V-Vekaria/LightGuide-Edge/deliverables/VekariyaVishnuB00969091_Slides.pptx

LightGuide Edge

A camera-free device that tells a photographer how to fix their lighting — in 21 microseconds, on a microcontroller.

Vishnu Vekariya · B00969091 · COM683 Edge and Embedded Intelligence · CW2

Notes: Open with the problem in one sentence, not an agenda. 12 minutes, 15 slides.

## Slide 2

The problem

Small-studio and freelance photographers have no feedback loop on lighting setup

- Lighting is set by eye, then re-set by eye at every session. Nothing records what "correct" was.
- Getting it wrong costs a reshoot: wasted travel, wasted studio hire, wasted energy — SDG 12, responsible consumption.
- The people worst affected are freelancers and small businesses without an assistant or a light meter — SDG 8, decent work and productive employment.
- Existing aids are cameras or phone apps: they need a lens pointed at the subject, which is a privacy problem in client work.

The opportunity for innovation

A sub-£30 device that senses geometry and light directly, judges the setup against a saved reference, and guides the operator back — with no camera, no cloud and no personal data.

£30

0

5

bill of materials

images captured

setup faults detected

Cost and privacy are the two barriers this removes.

Notes: Say the phrase 'opportunity for innovation' out loud — the top band language is explicit. Ground SDG 12 in reshoots, SDG 8 in freelancers without an assistant.

## Slide 3

The solution, and why machine learning earns its place

Sense → classify → guide, as a closed loop on the device

1 Sense

Ultrasonic range and an LDR, sampled at 8 Hz. The LDR is read inside the ultrasonic ping gaps so the two channels never contend.

2 Classify

A window of 10 samples becomes 8 features, classified on-device into one of five setup states.

3 Guide

OLED text, an LED and a buzzer whose pitch encodes direction and rate encodes urgency.

Why not a pair of thresholds?

Because the two channels are physically coupled. Illuminance falls with the square of distance, so moving the stand changes the light reading even when the lamp has not been touched. A fixed light threshold therefore fires on a distance error, and a fixed distance threshold misses a lighting one. The classifier learns the joint region instead — and the ablation on slide 12 measures exactly what that coupling is worth: 0.41 and 0.46 macro-F1 for each channel alone, 0.87 together.

Placed at the edge, deliberately

Inference is 21 µs against a 125 ms sensing period, so the loop is bound by physics, not compute. Nothing leaves the device — the privacy argument and the latency argument point the same way here (Buyya and Srirama, 2019; Situnayake and Plunkett, 2022).

Notes: The inverse-square coupling is the intellectual core of the project. If you only get one idea across, make it this one.

## Slide 4

Ethical, technical and social context

What the design chooses not to do is as important as what it does

Ethical — privacy by construction

No camera, no microphone, no images, no personal data. The device cannot identify a person because it never senses one: it measures distance to a surface and light falling on a cell. Privacy is a property of the sensor choice, not of a policy.

Technical — the constraint is RAM

46.7 KB of 256 KB static RAM and 12.3% of flash. On microcontrollers the binding limit is memory, not arithmetic (Warden and Situnayake, 2019), which is why an 8-feature tree beats a neural network here.

Social — who it is for

Aimed at freelancers and small studios, the users least able to absorb a reshoot. A sub-£30 device with no subscription and no account is accessible in a way a metered app is not.

Notes: Trim this slide first if running over time.

## Slide 5

Data collection methodology

1,832 labelled samples · 45 runs · 3 sessions · 5 classes · 0 dropouts, 0 NaNs

- Five classes: optimal, too_close, too_far, underlit, overlit. Each defined relative to a saved reference setup, not to an absolute distance — so a reference saved next week still works.
- Three sessions on different days, with the rig re-referenced each time. Session 3 is held out entirely and never seen during training.
- 8 Hz sampling: fast enough to catch the operator settling, slow enough that the ultrasonic ping and the LDR settling do not contend.
- The staged label is written by the host at the moment of the trial, so ground truth is recorded, not reconstructed from memory afterwards.

Why session-split, not random

At 8 Hz consecutive samples are near-duplicates. A random split puts near-identical windows on both sides and reports a score that measures memorisation. Splitting by session — and grouping cross-validation by run — makes the test set answer the question that matters: does this work on a day it has not seen?

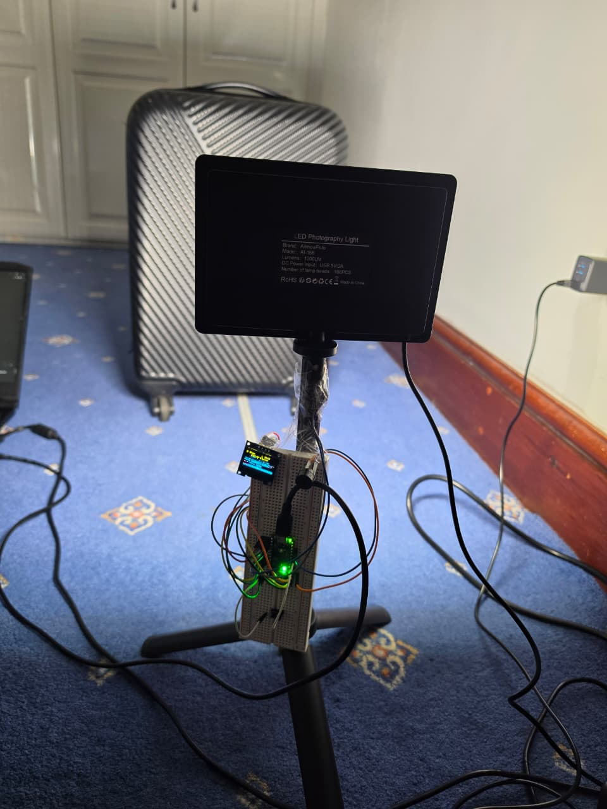
[picture p2: figure]

The rig as used for collection: lamp and sensor board on one stand.

Notes: The session-split argument is the highest-value point on the 15% data row. Say it explicitly.

## Slide 6

Data quality controls

Calibration against an independent reference, then filtering, gating and audit

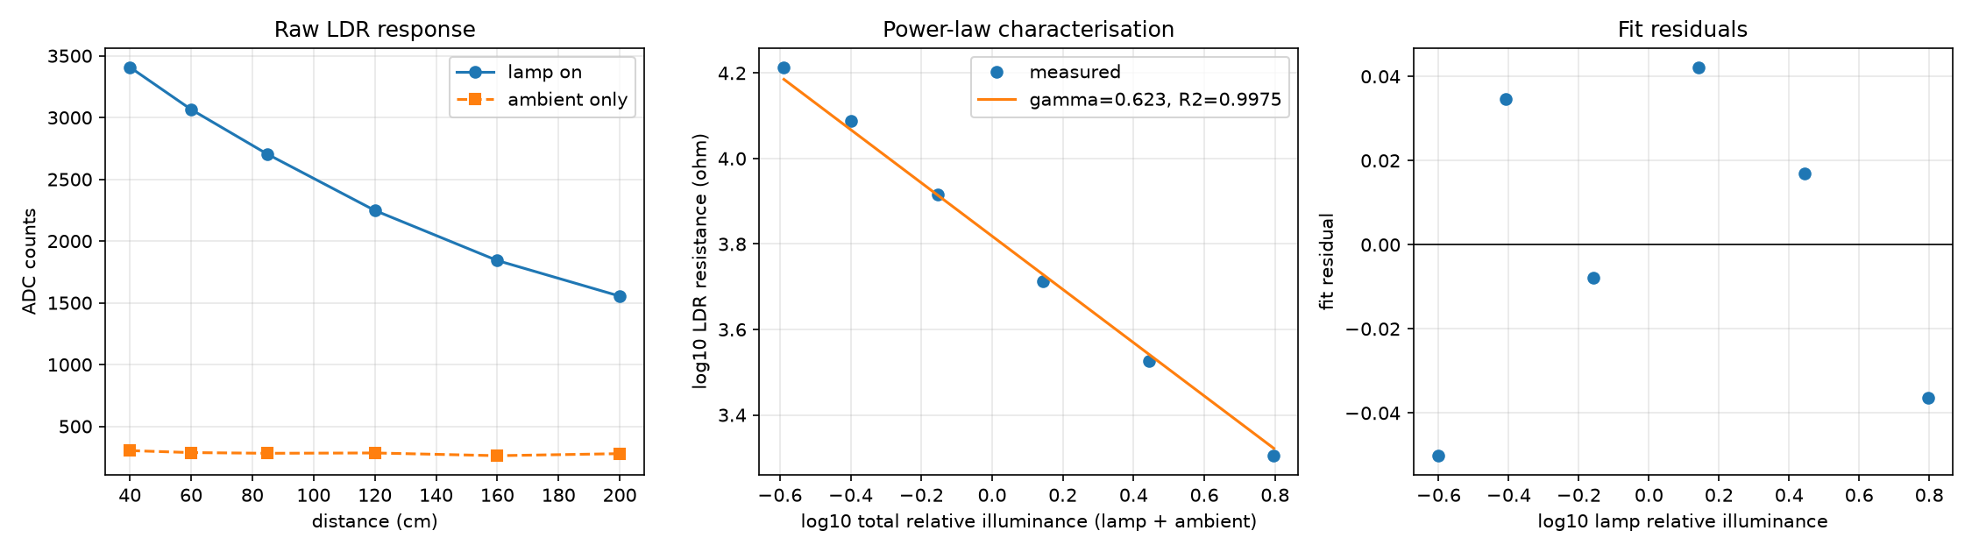
[picture p3: figure]

Six-point sweep, 40–200 cm, lamp output held fixed; distance is the reference instrument via the inverse-square law.

Ambient is fitted, not assumed

A lamp-off reading at every distance gives the room's own contribution, subtracted in the resistance domain — counts are non-linear in illuminance, so subtracting counts would subtract the wrong quantity.

0.623

0.9975

0.9913

7.2 mm

A measurement, not a convenience

One point at 200 cm read 134 mm long while every other read 1–22 mm short. The beam cone is 527 mm wide there against a 200 mm target, so the echo came off the wall behind. It is auto-flagged and excluded, and the report shows it rather than hiding it.

LDR γ (CdS band 0.5–0.9)

R² of the power-law fit

APDS9960 cross-check r

ultrasonic RMSE ≤160 cm

Notes: If asked why no lux meter: absolute lux is not needed because every class is relative to a saved reference. What is needed is the response curve, and distance gives that for free.

## Slide 7

Preprocessing and features

Two channels, ten samples, eight numbers

Windowing

10 samples at 8 Hz = 1.25 s, 50% overlap (stride 5). Long enough to average out a bad echo, short enough that the operator is not left waiting.

Deviations, not absolutes

Both channels are stored as a difference from the saved reference: d_dist_mm and d_ldr. The model learns how far off the rig is, not where it happens to be standing.

Eight features

mean, std, min, max — for each of the two channels. Chosen to be computable in a single pass on-device with no buffering beyond the window itself.

Leakage avoided at every step

The scaler is fitted on training data only and frozen before it ever touches the test session. Cross-validation is grouped by run, so no two windows from the same run can land on opposite sides of a fold.

Readings the model was never trained on are refused

A failed echo was dropped from the dataset rather than interpolated, so the firmware also refuses to push one into the classifier. The device shows the channel as unread instead of inventing a value — the training and deployment paths make the same choice.

Notes: The frozen-scaler and grouped-CV points are what separates a 2:1 from a 1st on the ML row. State both.

## Slide 8

Four modelling approaches, and why each

Nothing was tuned to flatter one side

M0 Classical baselines

Decision tree, k-NN, logistic regression, random forest. A tree is interpretable and its split thresholds can be checked against the physical tolerances — when they agree, that is independent evidence the dataset is sane.

M1 MLP (32-16)

The obvious neural baseline on the same 8 features. Tests whether a learned non-linear boundary beats an axis-aligned one on this problem.

M2 Autoencoder novelty gate

Trained on optimal windows only. High reconstruction error means "this is not a setup I recognise", so the device can say UNKNOWN SETUP rather than confidently pick a wrong class.

M3 Sequence model / Edge Impulse

Same windows, same splits — but 20 raw timestep values instead of 8 summary statistics, trained as an INT8 TFLM network in Edge Impulse.

Notes: M2 is the closest thing here to a novelty claim — but its recall is 0.169, so present it as a partial result, not a success.

## Slide 9

Validation and deployment

Grouped 5-fold CV, a held-out session, and a footprint measured rather than estimated

- 5-fold cross-validation grouped by run; 195 training windows, 104 held-out test windows from session 3.
- Five seeds per model — the reported spread is real variance, not a single lucky run.
- Deployed model is the decision tree, exported to model.h as plain C: no library dependency, no tensor arena, no quantisation error.
- Footprint read from the compiler, not estimated — regenerate with tools/record_footprint.py.

The INT8 network exists — and was not deployed

CW1 promised an INT8 TensorFlow Lite Micro model. It was built in Edge Impulse on identical windows (195 train / 104 test on both sides) and measured. The tree beat it by 20 percentage points, so the tree shipped. Choosing not to deploy is a result, not an omission.

120,896 B

46,696 B

20.8 µs

Public project

studio.edgeimpulse.com/public/1082649/live — Vish_Vekzz / LightGuide-Edge, open without a login.

flash — 12.3% of 983,040

static RAM — 17.8% of 256 KB

mean inference, p95 21.0

Notes: Have the EI page open in a tab in case they want to see it during Q&A.

## Slide 10

Results — offline

Held-out session 3, never seen in training

model | CV macro-F1 | test macro-F1
M0a Decision Tree | 0.882 ± 0.237 | 0.868
M0d Random Forest | 0.896 ± 0.207 | 0.868
M1 MLP (32-16) | 0.858 ± 0.138 | 0.860
M0c Logistic Regression | 0.849 ± 0.148 | 0.786
M0b k-NN (k=5) | 0.784 ± 0.161 | 0.800
Majority baseline | — | 0.067

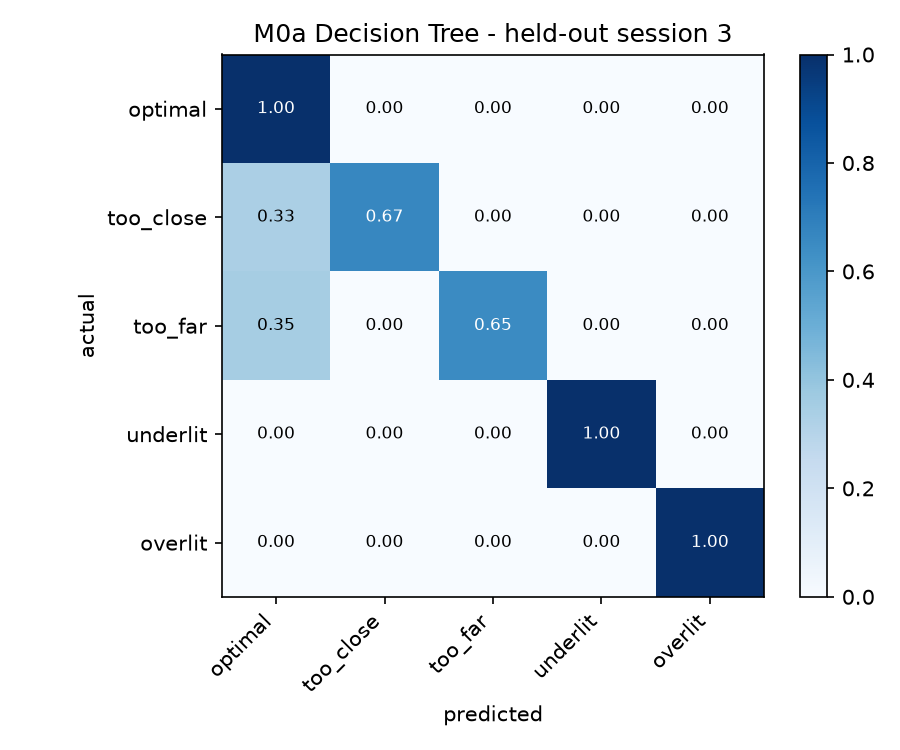
[picture p4: figure]

Every error is a distance class absorbed into optimal: too_close recall 0.67, too_far 0.65, both channels' lighting classes 1.00.

The generalisation gap is the point

CV 0.882 against held-out 0.868 — a gap of +0.014. Session-wise splitting exists to expose exactly this number; a random split would have hidden it and reported something flattering and false.

Notes: Optimal has precision 0.60 with recall 1.00 — it over-predicts. That is the near-boundary region, and it sets up slide 11.

## Slide 11

Results — online, on the device, in the room

40 staged runs · 1,648 classified samples · 0 dropouts

1.000

20.8 µs

8.09 Hz

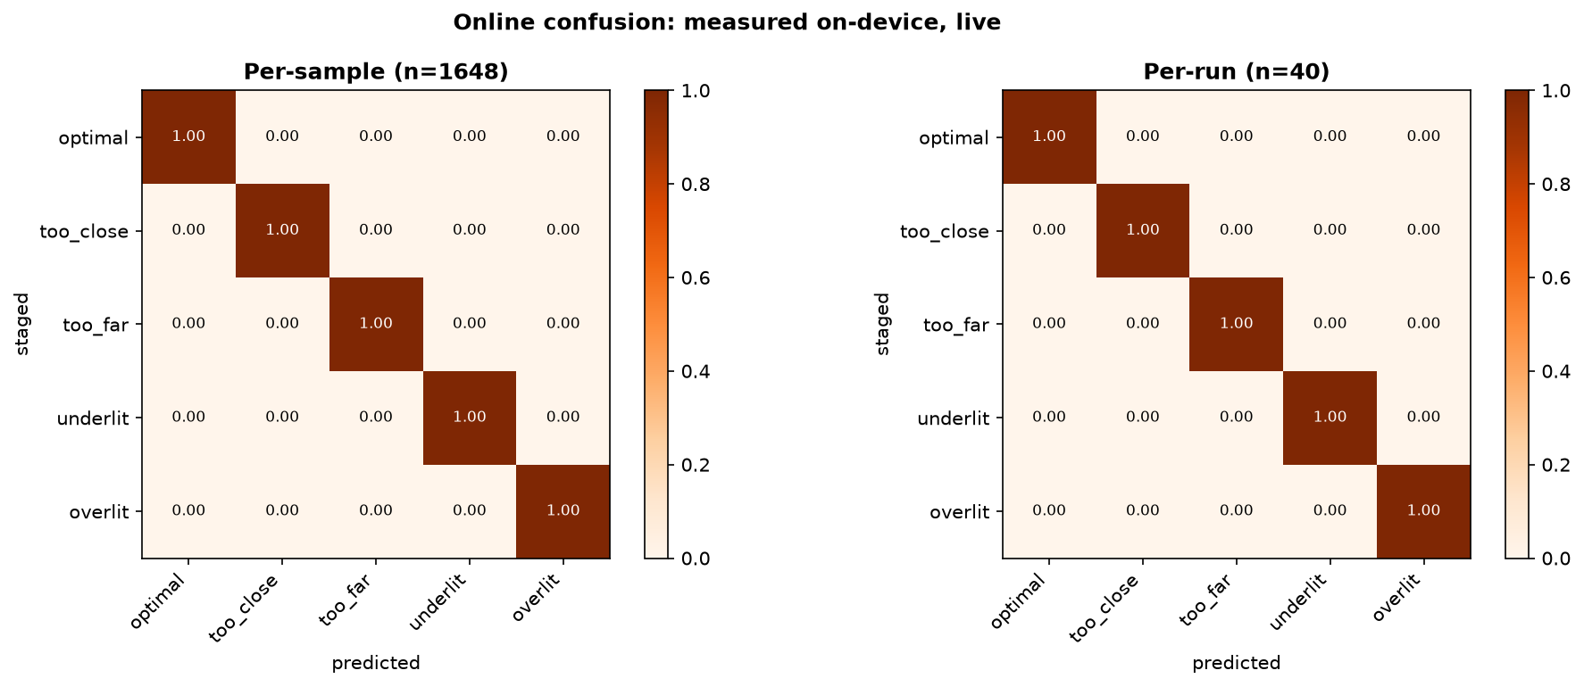
[picture p5: figure]

What it does establish: the deployed model reproduces its intended behaviour on every prototypical staging, with ground truth recorded at the trial.

per-run macro-F1

mean inference

sustained sample rate

Why 1.000 is NOT better than the offline 0.868

The two evaluations sample different regions. Online, every off-reference run was staged against a floor mark ~300 mm out, with a within-class spread of 2 mm. The held-out session contains windows only 33–38 mm past a 30 mm tolerance — the boundary region, which is precisely where slide 10's errors live. The online score is a property of the protocol, not evidence the device improved.

Notes: Do not oversell this. Volunteering the caveat before you are asked is worth more than the 1.000 itself. The honest next measurement is a boundary sweep at +4, +6, +10 cm.

## Slide 12

Ablation, failure analysis and limitations

What each sensor is worth, and where the device is known to break

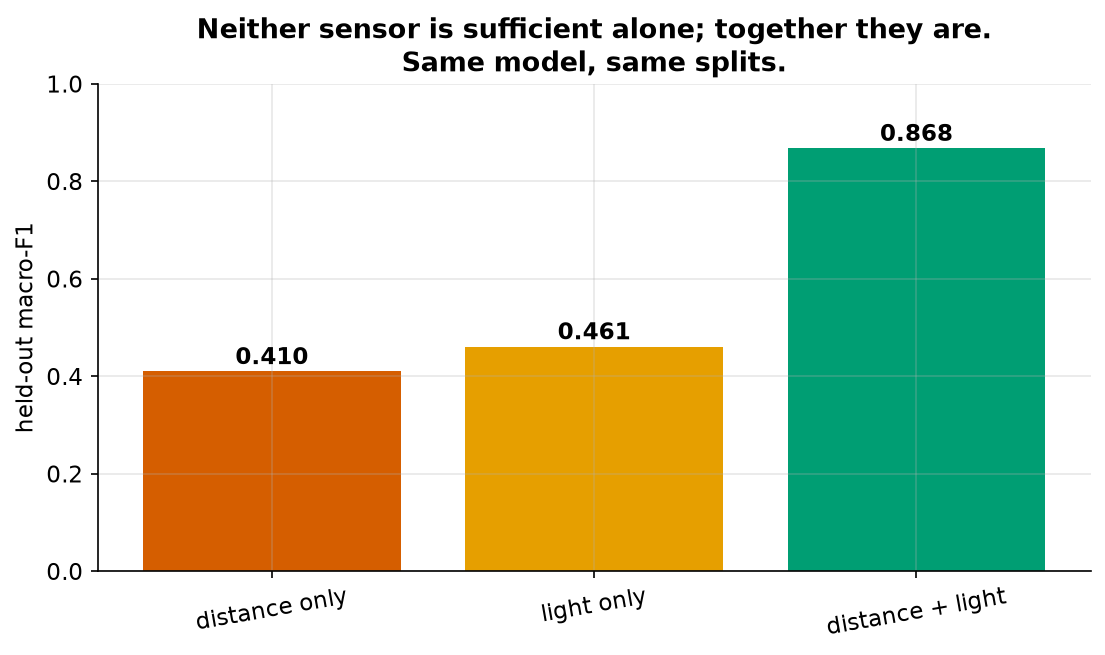
[picture p6: figure]

Distance alone 0.410, light alone 0.461, both 0.868 — the coupling from slide 3, measured.

Near the tolerance boundary

too_close and too_far fall into optimal at 0.67 and 0.65 recall. Errors are concentrated within tens of millimetres of the band edge.

The novelty gate under-fires

M2 precision 1.000 but recall 0.169 — when it says UNKNOWN it is right, but it stays silent on most genuine deviations. Reported as a partial result.

Ultrasonic beyond ~160 cm

With a 200 mm target the 527 mm beam cone picks up the background. Measured, not assumed.

tilt_off never collected

Scope was cut to five classes; documented in docs/12-SCOPE-CHANGE-TILT.md rather than quietly dropped.

Notes: Volunteer all four. A limitation you raise yourself reads as rigour; the same one raised by the marker reads as an oversight.

## Slide 13

Demo

Live device — video fallback ready

0:00

Hold D7 for 2 s

REFERENCE SAVED

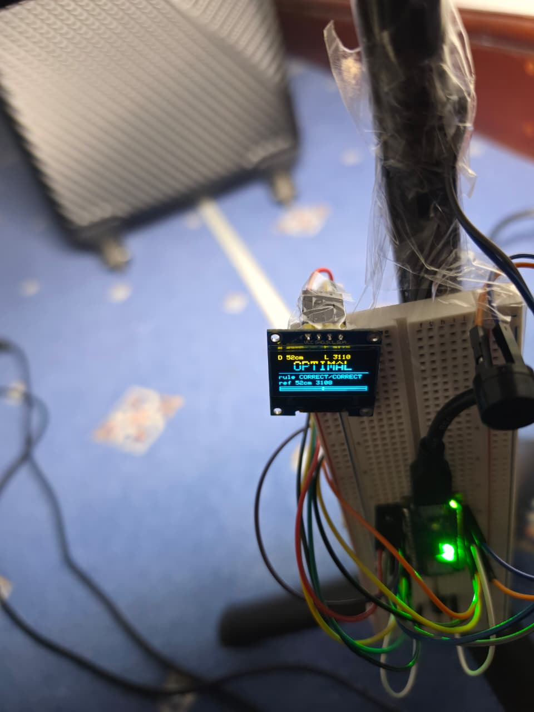
[picture p7: figure]

0:08

Settled at the reference

OPTIMAL

0:16

Stand ~30 cm closer

TOO CLOSE — MOVE BACK

0:26

Stand back past the reference

TOO FAR — MOVE IN

0:36

Return, then dim the lamp

UNDERLIT — INCREASE OUTPUT

0:46

Brighten above the reference

OVERLIT — REDUCE OUTPUT

0:54

Restore the reference setup

OPTIMAL

All five classes in under 60 seconds, hardware visibly responding to a physical change.

Notes: UNKNOWN SETUP only if it fires in the first two attempts — M2 recall is 0.169. Promising it and having it not fire is worse than not promising it. State the boundary limitation out loud during the demo.

## Slide 14

Conclusion

A £30 camera-free device that classifies five lighting-setup faults on-device at 20.8 µs, held-out macro-F1 0.868, using 12.3% of flash.

Boundary sweep

Stage too_far at +4, +6 and +10 cm instead of +30 and measure where on-device accuracy actually breaks. The offline test cannot answer this — it depends on settling behaviour a CSV replay never sees.

Fix the novelty gate

M2 recall 0.169 is too low to ship. Either lower the threshold and re-measure precision, or replace the autoencoder with a distance-to-training-manifold test.

Widen the ultrasonic target

A larger or textured reference surface should extend usable range past the measured 160 cm limit.

Collect tilt_off

The sixth class was cut for scope. The IMU is already on the board and already read.

Every item above is tied to a number measured in this project, not a wish list.

Notes: Close on the boundary sweep — it shows you know what your own headline number does not prove.

## Slide 15

References

Harvard · left on screen during Q&A

Buyya, R. and Srirama, S.N. (eds.) (2019) Fog and Edge Computing: Principles and Paradigms. Hoboken, NJ: John Wiley & Sons.
Iodice, G.M. (2023) TinyML Cookbook: Combine artificial intelligence and ultra-low-power embedded devices to make the world smarter. 2nd edn. Birmingham: Packt Publishing.
Situnayake, D. and Plunkett, J. (2022) AI at the Edge. Sebastopol, CA: O'Reilly Media.
Warden, P. and Situnayake, D. (2019) TinyML: Machine Learning with TensorFlow Lite on Arduino and Ultra-Low-Power Microcontrollers. Sebastopol, CA: O'Reilly Media.

Technical documentation

Arduino Nano 33 BLE Sense documentation · Nordic Semiconductor nRF52840 datasheet · Edge Impulse documentation · TensorFlow Lite for Microcontrollers documentation · HC-SR04 and GL5528 component datasheets.

Notes: Each set text maps to a specific claim: Warden and Situnayake for the RAM-bound argument, Situnayake and Plunkett for online evaluation, Buyya and Srirama for edge placement, Iodice for the Nano workflow. Be ready to say what each supports.
