V-Vekaria/LightGuide-Edge/reports/figures/feature_space.png

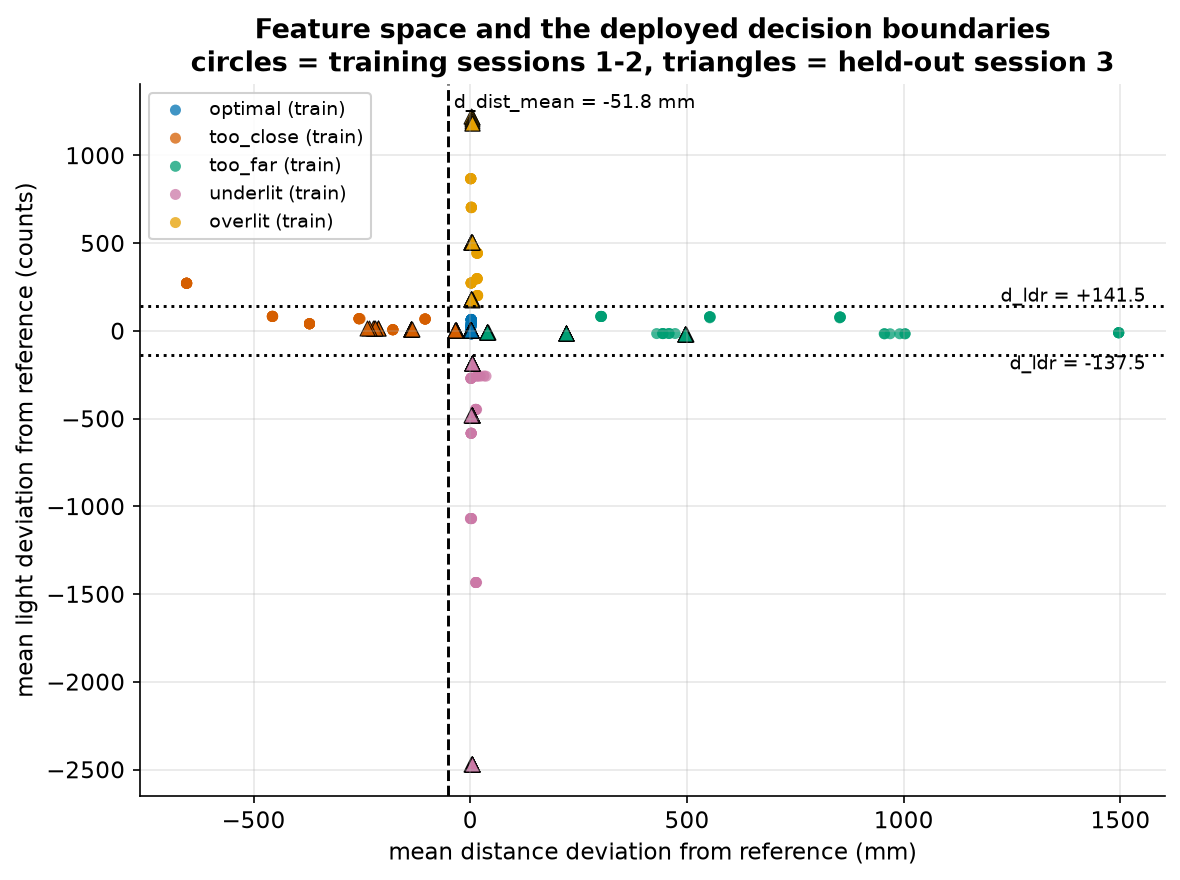
reports/figures/feature_space.png
