V-Vekaria/LightGuide-Edge/reports/figures/model_comparison.png

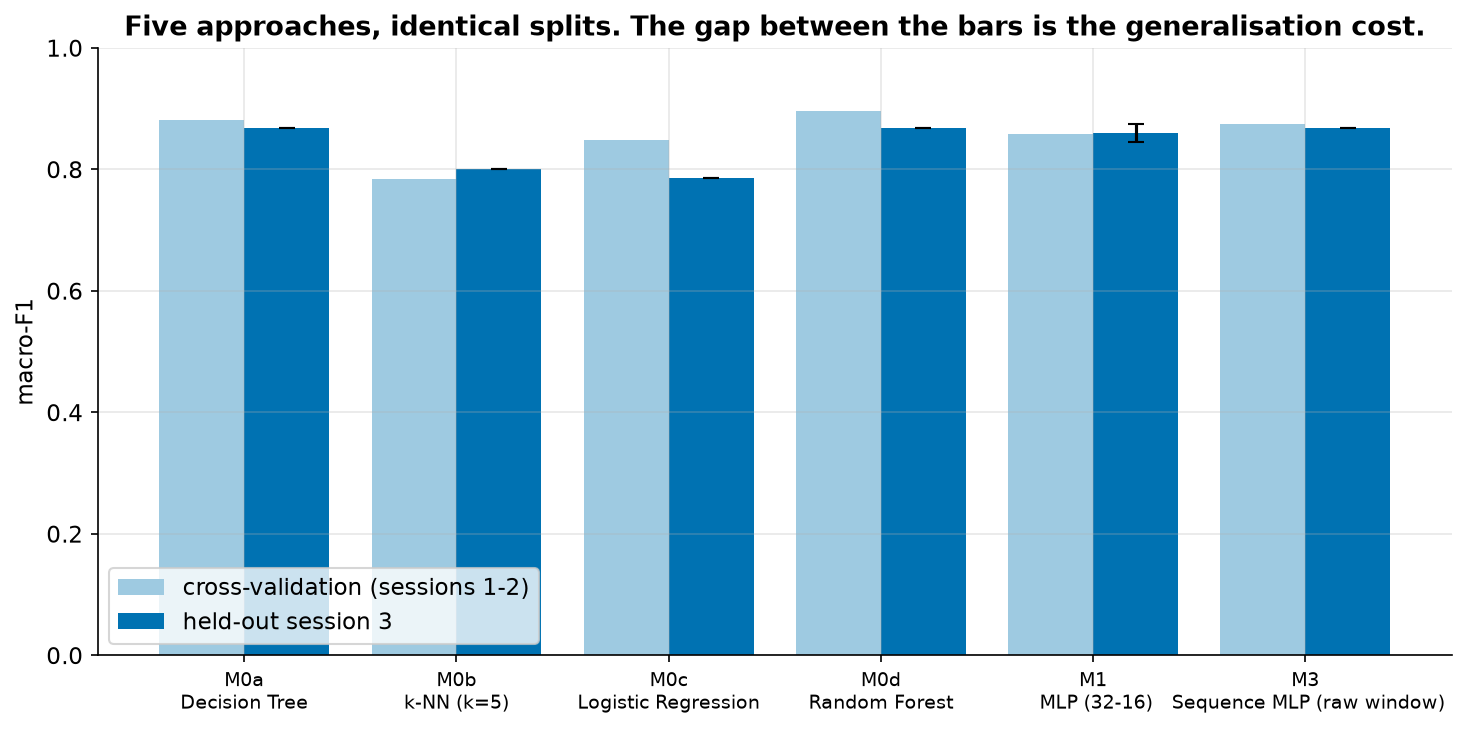
reports/figures/model_comparison.png
