V-Vekaria/LightGuide-Edge/reports/figures/session_references.png

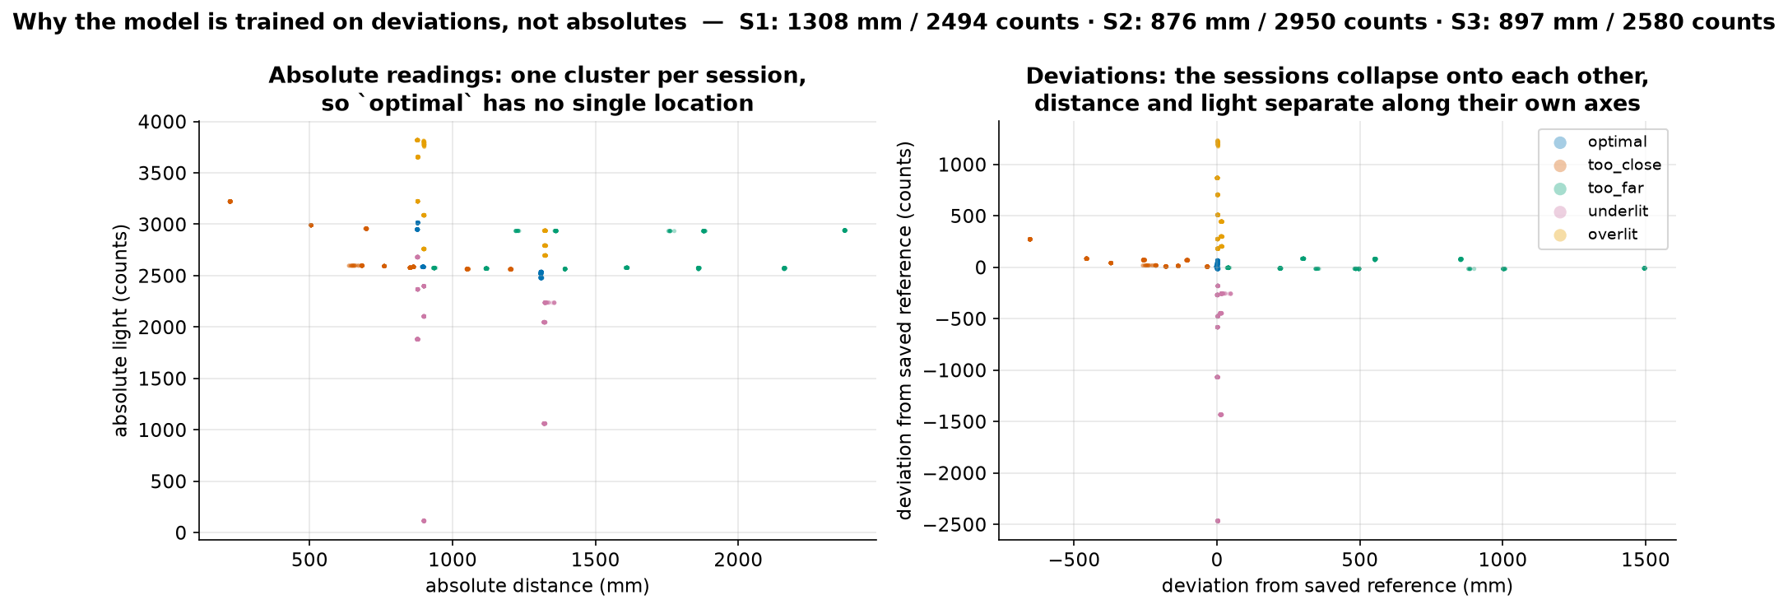
reports/figures/session_references.png
