V-Vekaria/LightGuide-Edge/reports/figures/traces_by_class.png

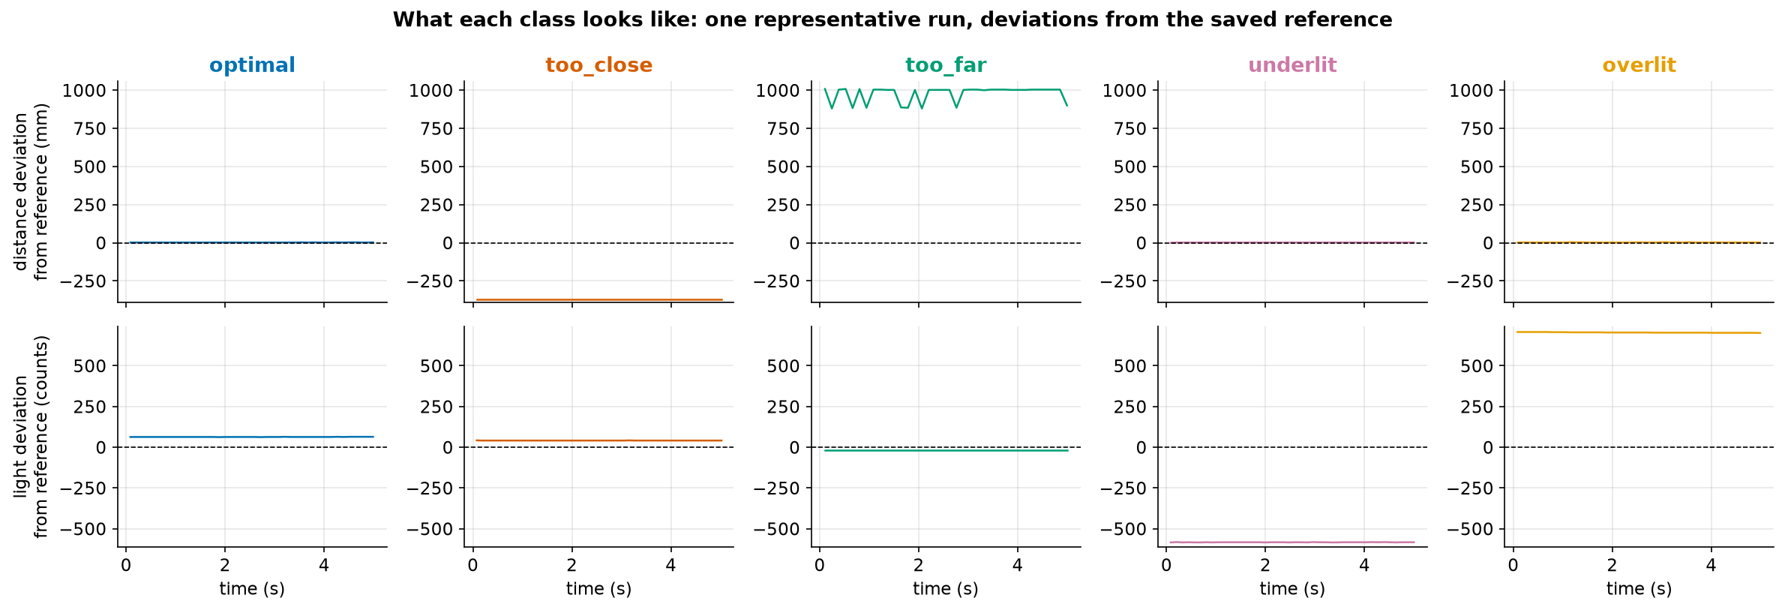
reports/figures/traces_by_class.png
