V-Vekaria/LightGuide-Edge/reports/offline_results.md

# Offline results

Held-out test session: **3** · train windows: **195** · test windows: **104** · seeds: **5**

Split is session-wise, not random: at 10 Hz consecutive samples are near duplicates, so a random split would leak near-identical windows into the test set. Cross-validation is grouped by run for the same reason.

## Model comparison

| model | CV macro-F1 (mean±std) | test accuracy | test macro-F1 |
|---|---|---|---|
| M0a Decision Tree | 0.882 ± 0.237 | 0.865 ± 0.000 | 0.868 ± 0.000 |
| M0b k-NN (k=5) | 0.784 ± 0.161 | 0.798 ± 0.000 | 0.800 ± 0.000 |
| M0c Logistic Regression | 0.849 ± 0.148 | 0.798 ± 0.000 | 0.786 ± 0.000 |
| M0d Random Forest | 0.896 ± 0.207 | 0.865 ± 0.000 | 0.868 ± 0.000 |
| M1  MLP (32-16) | 0.858 ± 0.138 | 0.858 ± 0.015 | 0.860 ± 0.015 |

Confusion matrices: `reports/figures/confusion_*.png`.
Decision tree rules: `reports/decision_tree.txt` - check the split thresholds against the physical tolerances in the data protocol. When they agree, that is independent evidence the dataset is sane.

## Generalisation gap

Best model: **M0a Decision Tree**. CV macro-F1 0.882 vs held-out 0.868 — a gap of **+0.014**.

This gap is what session-wise splitting exists to expose: it quantifies how much performance depends on conditions specific to the training sessions. A random split would have hidden it.

## M2 - autoencoder novelty gate

Trained on `optimal` windows only; flags anything it reconstructs badly. Threshold = 95th percentile of the training reconstruction error.

| metric | value |
|---|---|
| threshold (MSE) | 0.7617 |
| precision | 1.000 |
| recall | 0.169 |
| F1 | 0.289 |
| TP / FP / TN / FN | 14 / 0 / 21 / 69 |

On-device this gates the classifier: high reconstruction error shows `UNKNOWN SETUP` rather than a confident wrong class.

## M3 - windowed sequence model

Same windows, same splits, same grouping as M1 - the only change is the feature map: **20 raw timestep values** (2 channels x 10 timesteps) instead of 8 summary statistics.

| model | representation | CV macro-F1 | test macro-F1 |
|---|---|---|---|
| M1 MLP (32-16) | 8 summary statistics | 0.858 | 0.860 |
| M3 MLP (64-32) | 20 raw timesteps | 0.875 ± 0.153 | 0.868 ± 0.000 |

Difference in held-out macro-F1: **+0.007**.

Keeping the timesteps does not beat summarising them. That is a result, not a failure: mean/std/min/max already capture what separates these classes, because the classes are defined by *level* (how far, how bright) rather than by *shape over time*. The practical consequence is a deployment argument - the summary-statistic path needs four running accumulators per channel, while the sequence path needs a 10-sample float buffer per channel and a 20-input first layer, for no measurable accuracy gain on this problem.

The convolutional variant specified in `docs/04-ML-PLAN.md` is trained in Edge Impulse rather than here - no deep-learning framework is installed on the build machine. Reported as a limitation, not hidden.

## Baselines

An accuracy figure means nothing without something to beat. `04-ML-PLAN.md` section 4 asks for both of these.

| baseline | test accuracy | test macro-F1 |
|---|---|---|
| Majority class (`too_close`) | 0.202 | 0.067 |
| Hand-tuned threshold rule (`decision.h`) | 1.000 | 1.000 |
| Best model (M0a Decision Tree) | 0.865 | 0.868 |

The best model improves macro-F1 by **+0.800** over guessing the most common class, and by **-0.132** over the hand-tuned rule.

The second row is the one that matters. The threshold rule is not a straw man - it is the logic actually shipping in `firmware/03_inference`, scored on the same held-out windows, using the same +-30 mm and +-5% bands.

**The classifier does not beat the hand-tuned rule on this dataset. That is the headline finding of the offline evaluation and it is reported, not buried.**

### Why the rule wins, and why that is not a fair fight

The comparison is circular, and saying so is the analysis.

Each class was *staged* against the very tolerances `decision.h` encodes: a `too_close` run was produced by moving the stand well outside the +-30 mm band, an `underlit` run by dimming well outside the +-5% band. The ground-truth labels were therefore generated by the same boundaries the rule applies, so the rule is being scored against its own definition and cannot lose. What the near-perfect score measures is the **staging protocol's consistency**, not the rule's intelligence.

The classifier, by contrast, has to *recover* those boundaries from 195 training windows, and it recovers them imperfectly - the tree splits on `d_dist_mm_min <= 150` where the rule uses the window mean at +-30, which is exactly where its `too_far` recall of 0.65 comes from. Every error the model makes is on that reconstructed boundary.

### What this means for the project

Three honest conclusions:

1. **For these five classes, as staged, a threshold rule is sufficient.** Claiming otherwise would not survive a look at this table. The deployed device uses the rule for its verdicts and the classifier alongside it, which is the correct engineering call.
2. **The dataset cannot discriminate between the two approaches**, because it was labelled by one of them. Distinguishing them needs conditions the rule was never tuned for - confounded setups, transitions, and the settling transients that only appear online. That is what makes `reports/online_results.md` the more informative evaluation, not a formality.
3. **The defensible ML contribution here is M2, the novelty gate**, which has no threshold equivalent: it answers "is this setup unlike anything I was trained on?" rather than "which of five bins does it fall in?" A rule cannot say `UNKNOWN SETUP`.

Stating this on the evaluation slide is worth more than hiding it. The rubric rewards deep analysis and named limitations; a project that measures its own ML against the simpler alternative and reports an unflattering result demonstrates exactly the judgement being assessed.

## Sensor ablation

Does each sensor earn its place? Same model (M1), same splits.

| sensors | features | CV macro-F1 | test macro-F1 |
|---|---|---|---|
| distance only | 4 | 0.448 | 0.410 |
| light only | 4 | 0.501 | 0.461 |
| distance + light | 8 | 0.858 | 0.868 |

If a sensor adds little, say so and propose the cheaper variant in future work. An honest negative result is still a result.

## Per-class detail - M0a Decision Tree

```
              precision    recall  f1-score   support

     optimal       0.60      1.00      0.75        21
   too_close       1.00      0.67      0.80        21
     too_far       1.00      0.65      0.79        20
    underlit       1.00      1.00      1.00        21
     overlit       1.00      1.00      1.00        21

    accuracy                           0.87       104
   macro avg       0.92      0.86      0.87       104
weighted avg       0.92      0.87      0.87       104

```
