V-Vekaria/LightGuide-Edge/data/processed/test.csv

d_dist_mm_mean | d_dist_mm_std | d_dist_mm_min | d_dist_mm_max | d_ldr_mean | d_ldr_std | d_ldr_min | d_ldr_max | label
1.0 | 0.0 | 1.0 | 1.0 | 4.6 | 0.66332495807108 | 4.0 | 6.0 | 0
1.0 | 0.0 | 1.0 | 1.0 | 4.4 | 0.6633249580710799 | 4.0 | 6.0 | 0
1.0 | 0.0 | 1.0 | 1.0 | 4.5 | 0.5 | 4.0 | 5.0 | 0
0.9 | 0.3 | 0.0 | 1.0 | 4.5 | 0.5 | 4.0 | 5.0 | 0
0.9 | 0.30000000000000004 | 0.0 | 1.0 | 4.2 | 0.6 | 3.0 | 5.0 | 0
0.8 | 0.6 | -1.0 | 1.0 | 4.5 | 0.806225774829855 | 3.0 | 6.0 | 0
0.5 | 1.5652475842498528 | -2.0 | 4.0 | 4.8 | 0.7483314773547882 | 4.0 | 6.0 | 0
-0.9 | 0.9433981132056604 | -3.0 | 1.0 | 5.0 | 0.4472135954999579 | 4.0 | 6.0 | 0
-1.1 | 1.1357816691600546 | -3.0 | 1.0 | 5.2 | 0.39999999999999997 | 5.0 | 6.0 | 0
-0.5 | 1.5 | -3.0 | 3.0 | 5.0 | 0.6324555320336759 | 4.0 | 6.0 | 0
-0.1 | 1.1357816691600549 | -1.0 | 3.0 | 5.0 | 0.6324555320336759 | 4.0 | 6.0 | 0
-0.5 | 0.9219544457292888 | -3.0 | 0.0 | 4.9 | 0.5385164807134504 | 4.0 | 6.0 | 0
-0.7 | 1.1874342087037917 | -3.0 | 0.0 | 4.8 | 0.39999999999999997 | 4.0 | 5.0 | 0
-1.0 | 1.3416407864998738 | -3.0 | 0.0 | 5.2 | 0.39999999999999997 | 5.0 | 6.0 | 0
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
