V-Vekaria/LightGuide-Edge/(commit log)

2026-07-31 fix: bound echo timing and record hardware bring-up findings
    [01_sensor_check.ino, 02_data_logger.ino]
2026-07-31 feat: meter-free LDR and ultrasonic calibration
2026-07-31 feat: add wiring probe, diagnose unpowered HC-SR04
2026-08-04 feat: add interactive pin identification sketch
2026-08-04 fix: enumerate sensors on Wire1, retract false OLED verification
    [00c_voltmeter.ino, 00d_sensor_inventory.ino]
2026-08-04 docs: add physical pin positions and minimum wiring path
2026-08-04 fix: verify OLED and LDR presence instead of assuming
    [01_sensor_check.ino]
2026-08-04 docs: add rails-first build sheet with measured resistor value
2026-08-04 docs: record rail fault and OLED pin order
2026-08-04 fix: impedance-based LDR check, correct resistor value to 10k
    [01_sensor_check.ino]
2026-08-04 feat: add buzzer, LED and switch test
    [01d_output_test.ino]
2026-08-04 docs: record bring-up complete except switch
2026-08-04 docs: gate G0 acceptance report, LED and buzzer confirmed
2026-08-05 feat: button-triggered capture workflow
2026-08-06 feat: live sensor and channel-comparison sketches
2026-08-06 feat: add ultrasonic sensing to inference sketch
2026-08-06 feat: OLED display, buzzer and status LED
    [03_inference.ino]
2026-08-06 feat: hold button to set reference distance
2026-08-06 docs: drop SETUP mode, hold button to save
2026-08-06 test: phase 1 distance acceptance evidence
    [phase1_distance_60s_20260806.csv, phase1_endurance_5min_20260806.csv]
2026-08-06 test: boost APDS gain for fair channel comparison
    [light_channel_compare_20260806.csv, light_channel_compare_boosted_20260806.csv]
2026-08-06 test: LDR sweep after 10k swap, 68.5% of scale
    [light_sweep_10k_20260806.csv]
2026-08-06 feat: sample LDR inside ultrasonic ping gaps
2026-08-06 feat: light channel on screen, buzzer and LED
    [03_inference.ino]
2026-08-06 test: phase 2 light acceptance evidence
    [phase2_live_2min_20260806.csv]
2026-08-06 data: 1832 labelled samples across three sessions
    [session1_0_optimal_20260806_163130.csv, session1_0_optimal_20260806_163201.csv, session1_0_optimal_20260806_163218.csv, session1_1_too_close_20260806_163440.csv, session1_1_too_close_20260806_163509.csv, session1_1_too_close_20260806_163531.csv, session1_2_too_far_20260806_163754.csv, session1_2_too_far_20260806_163821.csv]
2026-08-06 chore: drop session99 scratch captures
    [session99_3_underlit_20260806_111647.csv, session99_3_underlit_20260806_111703.csv, session99_3_underlit_20260806_111714.csv, session99_4_overlit_20260806_111736.csv, session99_4_overlit_20260806_111743.csv]
2026-08-06 feat: train and compare five models, tree wins at 0.868
    [test.csv, train.csv]
2026-08-06 feat: on-device decision tree inference
2026-08-06 feat: log model prediction alongside staged label
2026-08-08 feat: online eval, 40 runs with staging guard
    Gate G6 closed: 40 runs, 1648 samples, 0 dropouts, per-run macro-F1
    1.000, latency mean 20.8 us / p95 21.0 us.
    Two harness defects surfaced during collection and are fixed here.
    The board free-runs at 10 Hz; leaving the port open and undrained
    across the operator prompts filled the OS buffer (~98 KB, ~4 min),
    back-pressure stalled the sketch inside Serial.print, and the next
    host write died with WriteFile error 22. A wedged sketch also stops
    servicing D7, which made the board look dead. Drainer reads and
    discards while waiting and parks for the duration of a run.
    check_staging compares each recorded run against the bands in
    decision.h. It caug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
    [online_trials_20260808_113613.csv, online_trials_20260808_121055.csv, online_trials_20260808_121855.csv, online_trials_20260808_122217_combined.csv]
2026-08-08 refactor: share serial drainer with calibrate
    calibrate.py had the same defect online_trial.py just hit: it opens the
    port once, then waits on three operator prompts per distance point. With
    --quick that is 19 unbounded waits, so the buffer fills, the sketch
    blocks in Serial.print and the sweep dies partway through.
    Moves open_port and Drainer into tools/serial_link.py so there is one
    implementation. calibrate.py also never asserted DTR, which RUN.md warns
    about, and crashed on rows[0] when every step bailed out - both fixed.
    Verified output-identical: check_staging still raises 15 flags on the
    8 Aug capture, and online_results.md regenerates byte-for-byte apart
    from its timestamp.
    [calibrate.py, online_trial.py, serial_link.py]
2026-08-08 feat: LDR and ultrasonic calibration, gate P1
    Six-point tape sweep, 40-200 cm, lamp on a second stand at LDR height.
    gamma = 0.623 (CdS band 0.5-0.9), R2 = 0.9975, APDS9960 cross-check
    r = 0.9913. Closes the CW1 open issue on the uncalibrated LDR.
    The ultrasonic fit needed an echo sanity check. The 200 cm point came
    back +134 mm while every other point read 1-22 mm short, which is the
    background-echo signature: the beam cone is 527 mm wide there against a
    ~200 mm panel, and a specular flat target can drop below the detector
    threshold while the wall behind it does not. Absorbed into the fit it
    gave slope 1.071 and RMSE 37.2 mm, which the report would have called a
    7% speed-of-sound error tha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
    [ldr_sweep.csv]
2026-08-08 fix: ship online trial rows in dataset zip
    [package_submission.py]
2026-08-08 feat: build CW2 presentation deck
    15 slides generated by tools/build_deck.js against the slide-by-slide map
    in docs/06-PRESENTATION-PLAN.md. Every figure comes from reports/ and
    every number is copied from a report, so a changed result regenerates
    the deck rather than being retyped into it.
    Citations are the four COM683 set texts only. docs/09-REFERENCES.md still
    marks items 1-15 as unread search tasks, and an unread citation is worse
    than none when the marker can ask what the paper said.
    Slide 11 leads with the caveat rather than the 1.000: the online and
    offline scores sample different regions of the input space, so the
    higher number is a property of the protocol.
    Deck validates clean a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
